Tetris2102/DIY_electron_detector/kicad_proj/documentation/3D_bottom_alpha.png

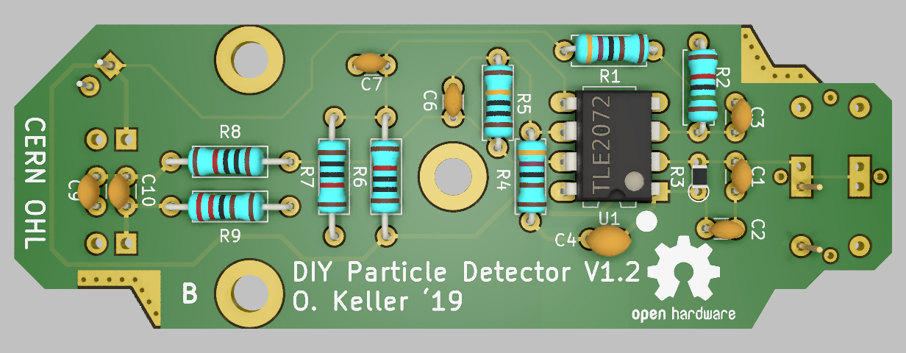
kicad_proj/documentation/3D_bottom_alpha.png
