Tetris2102/DIY_electron_detector/kicad_proj/documentation/3D_top_electron.png

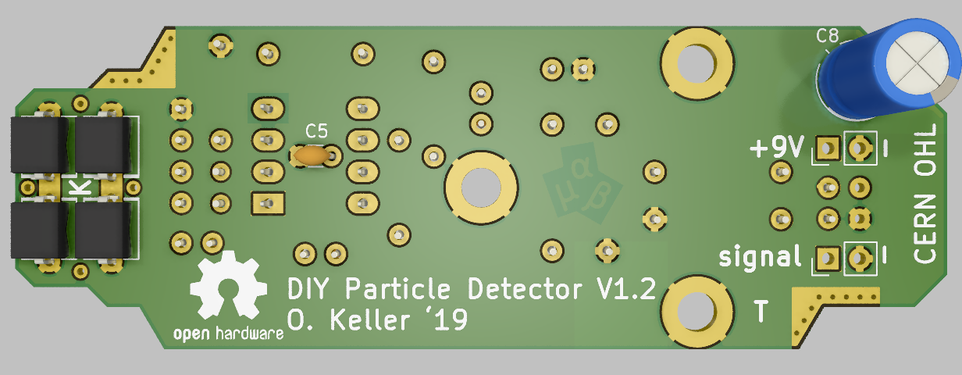
kicad_proj/documentation/3D_top_electron.png
