Tetris2102/DIY_electron_detector/kicad_proj/documentation/Alpha_spectrometer_in_candy_box_open.jpg

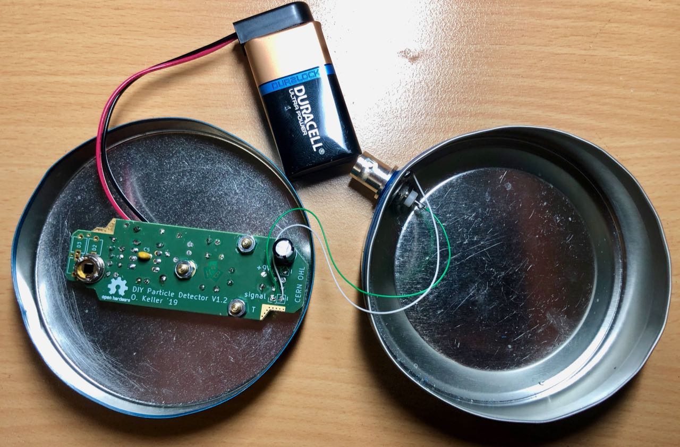
kicad_proj/documentation/Alpha_spectrometer_in_candy_box_open.jpg
