Tetris2102/DIY_electron_detector/kicad_proj/documentation/BPX61_onboard.jpg

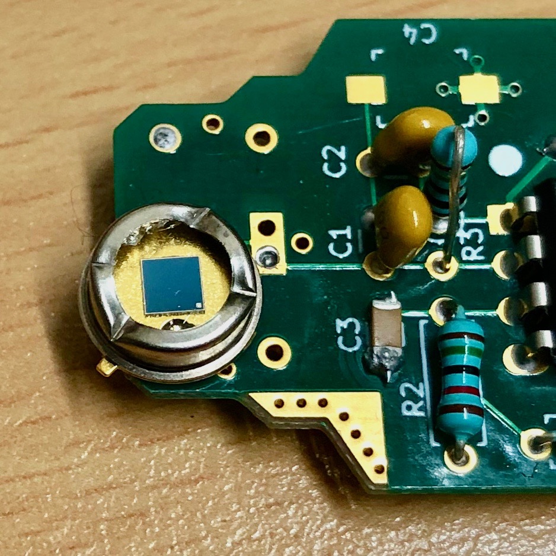
kicad_proj/documentation/BPX61_onboard.jpg
