Tetris2102/DIY_electron_detector/kicad_proj/documentation/BXP61_mircoscope.png

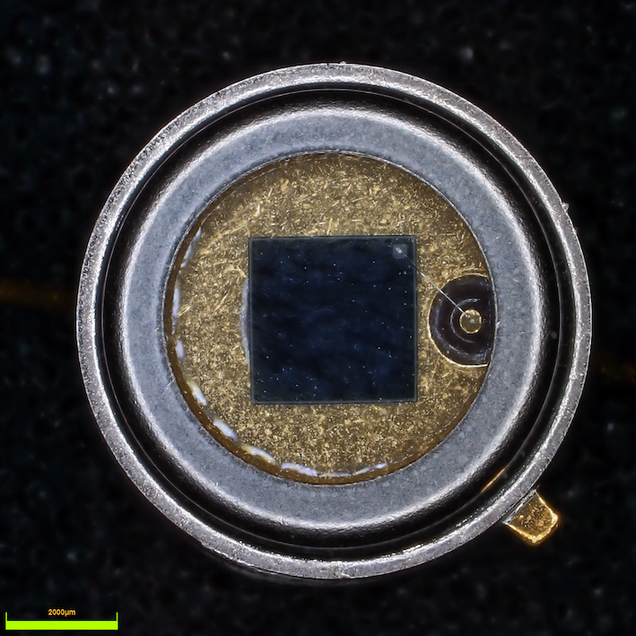
kicad_proj/documentation/BXP61_mircoscope.png
