Tetris2102/DIY_electron_detector/kicad_proj/documentation/DIY detector - parts overview v1-2 alphaspectrometer version.pdf

DIY Particle Detector v1.2 - overview of electronic components
1-diode variant for measuring energy of alpha particles and electrons
Resistor values in Ohm: | Capacitor values in Farad:
R1, R4 | 4k7 (4.7 k) | C1, C2 | 10 p
yellow purple black brown (brown) | marking: 100
R2 | 15 k | C3, C5, C7, C10 100 n
brown green black red (brown) | marking: 104
R3 | 40 M | C4 | C6 | C9
| 470 n | 3n3 | 6n8
black SMD resistor | (474) | (332) | (682)
(SMD = Surface Mounted Device)
C8 | 47 u
R5 | 1 M

polarity: short pin= - long pin = + brown black black yellow (brown) D1 or (http://www.apple.com/uk) D4: Silicon PIN Diode BPX61: R6, R7, R8 10 k
polarity: pin
| with notch
| = anode
brown black black red (brown)
R9 | 2k2 (2.2 k)

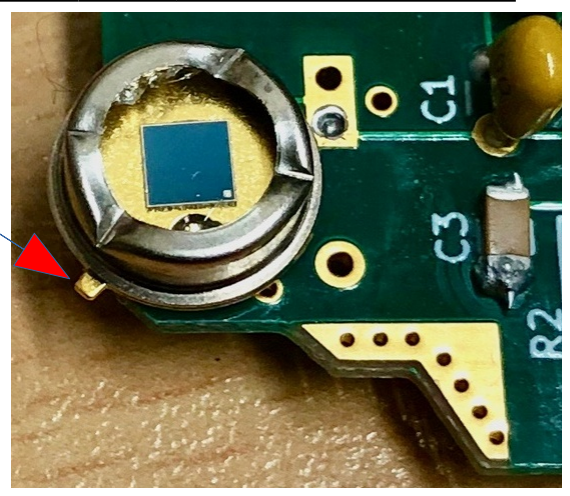
[picture p9: figure]

U1 Dual Operational Amplifier: red red black brown (brown)
| | | TLE2072(A)CP
| | | polarity: circles
| | | mark position of
| | | pin 1

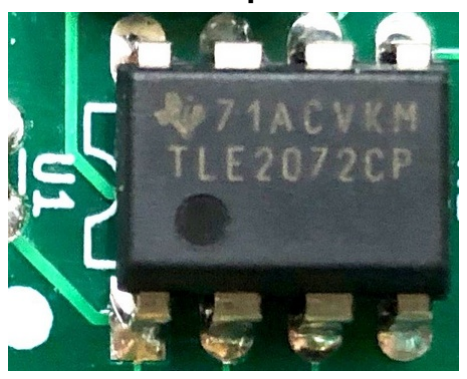
[picture p10: figure]

Check the main project description and schematic for general notes: www.github.com/ozel/DIY_particle_detector

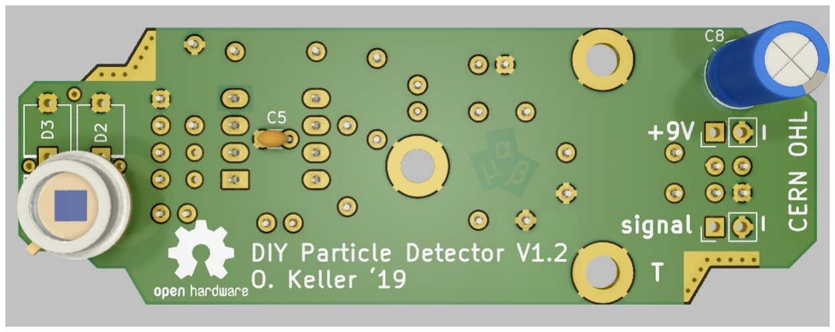
[picture p11: figure]
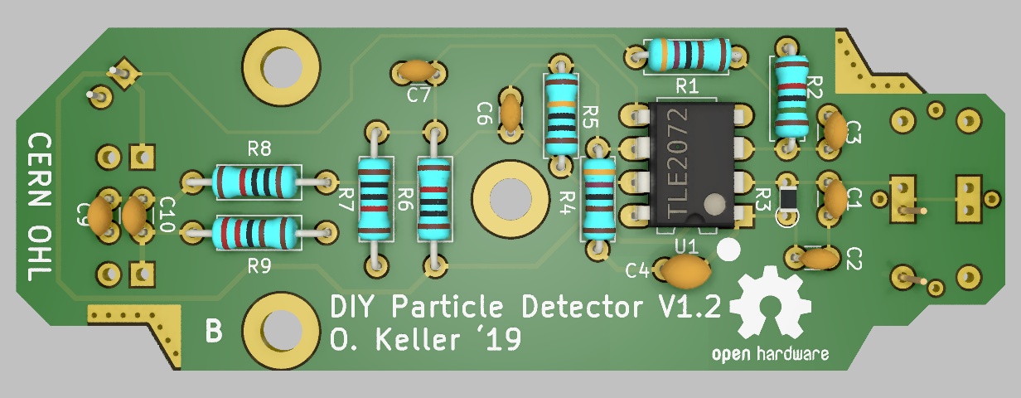
[picture p12: figure]
