Tetris2102/DIY_electron_detector/kicad_proj/3D/TLE2072.step

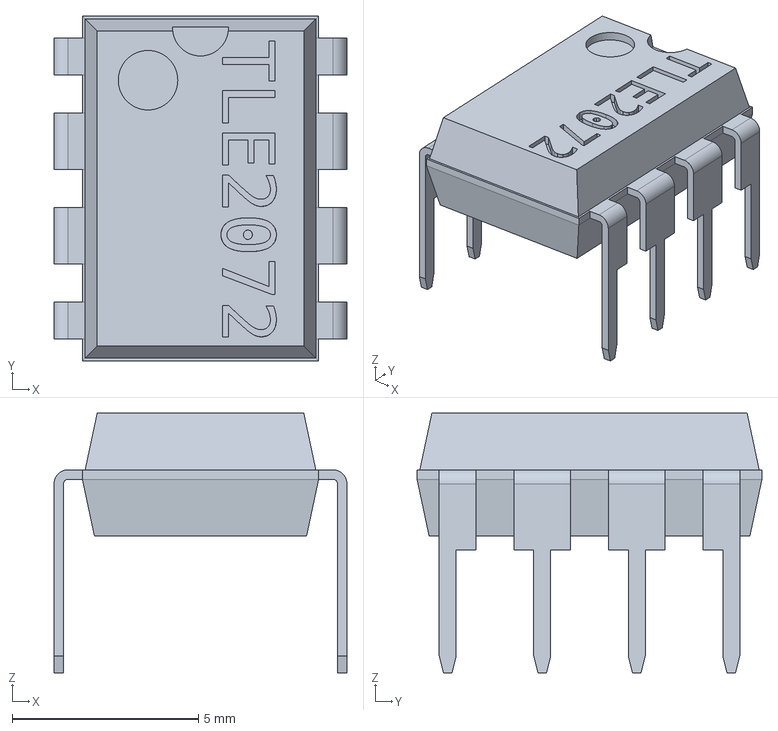
[picture p23: CAD file, 2025-08-24]
kicad_proj/3D/TLE2072.step
7.87 x 9.27 x 6.98 mm
