Tetris2102/DIY_electron_detector/kicad_proj/3D/BPX61.step

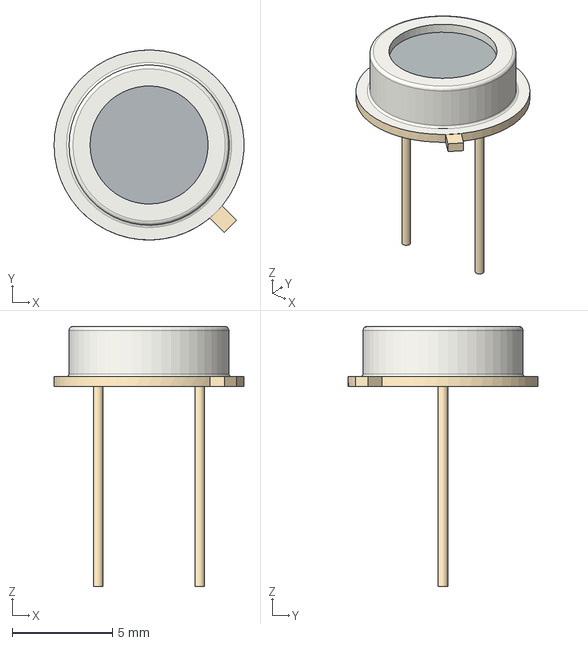
[picture p24: CAD file, 2025-08-24]
kicad_proj/3D/BPX61.step
9.49 x 9.50 x 13.0 mm
