Tetris2102/DIY_electron_detector/kicad_proj/3D/R_0805_2012Metric_THTorigin.FCStd

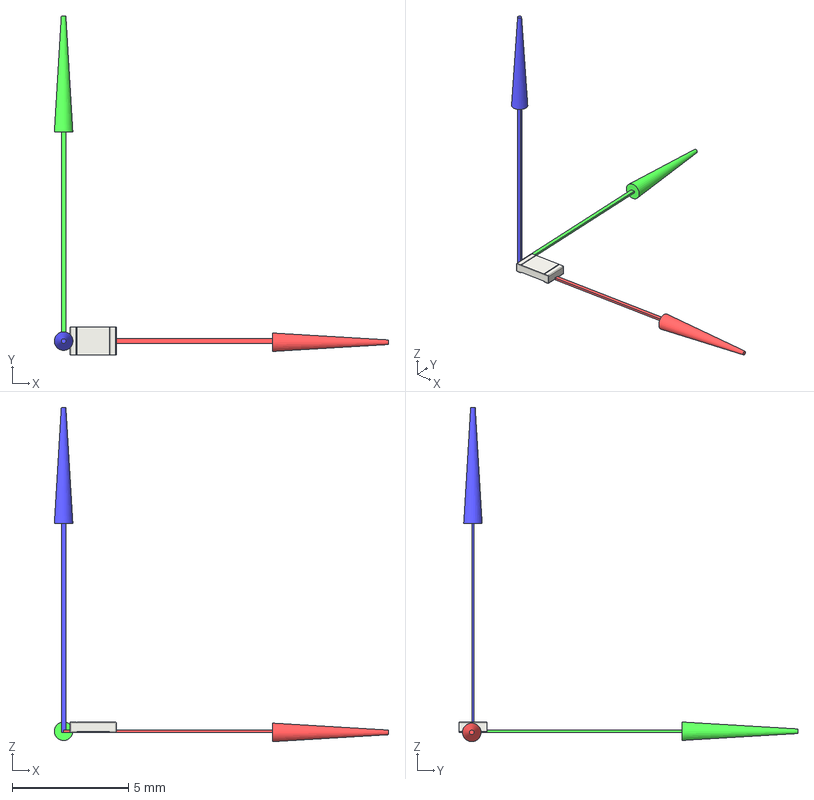
[picture p25: CAD file, 2025-08-24]
kicad_proj/3D/R_0805_2012Metric_THTorigin.FCStd
14.4 x 14.6 x 14.4 mm
R_0805_2012Metric_THTorigin
Z
Y
X
