Tetris2102/DIY_electron_detector/kicad_proj/3D/BPW34.FCStd

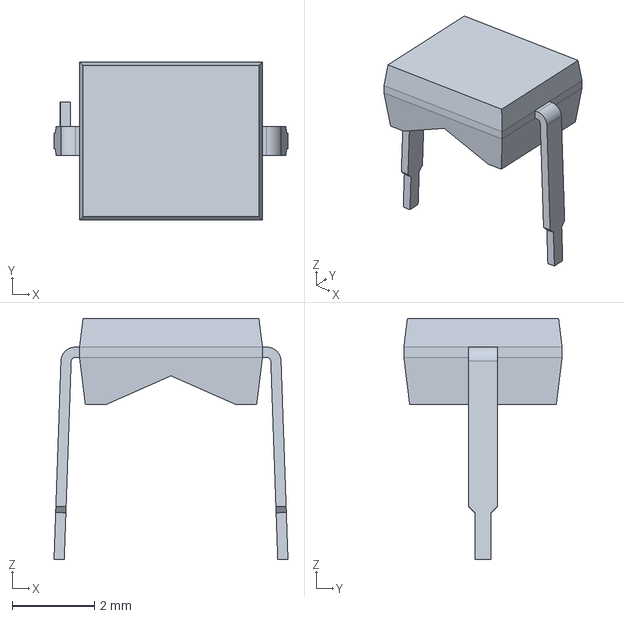
[picture p26: CAD file, 2025-08-24]
kicad_proj/3D/BPW34.FCStd
5.69 x 3.85 x 5.87 mm
