Tetris2102/DIY_electron_detector/(list of files, cad)

Other CAD files:
kicad_proj/3D/TLE2072ACP.FCStd
kicad_proj/3D/BPW34F.step
kicad_proj/3D/BPX61.FCStd
