Tetris2102/DIY_electron_detector/kicad_proj/documentation/DIY particle detector schematic v1-2.pdf

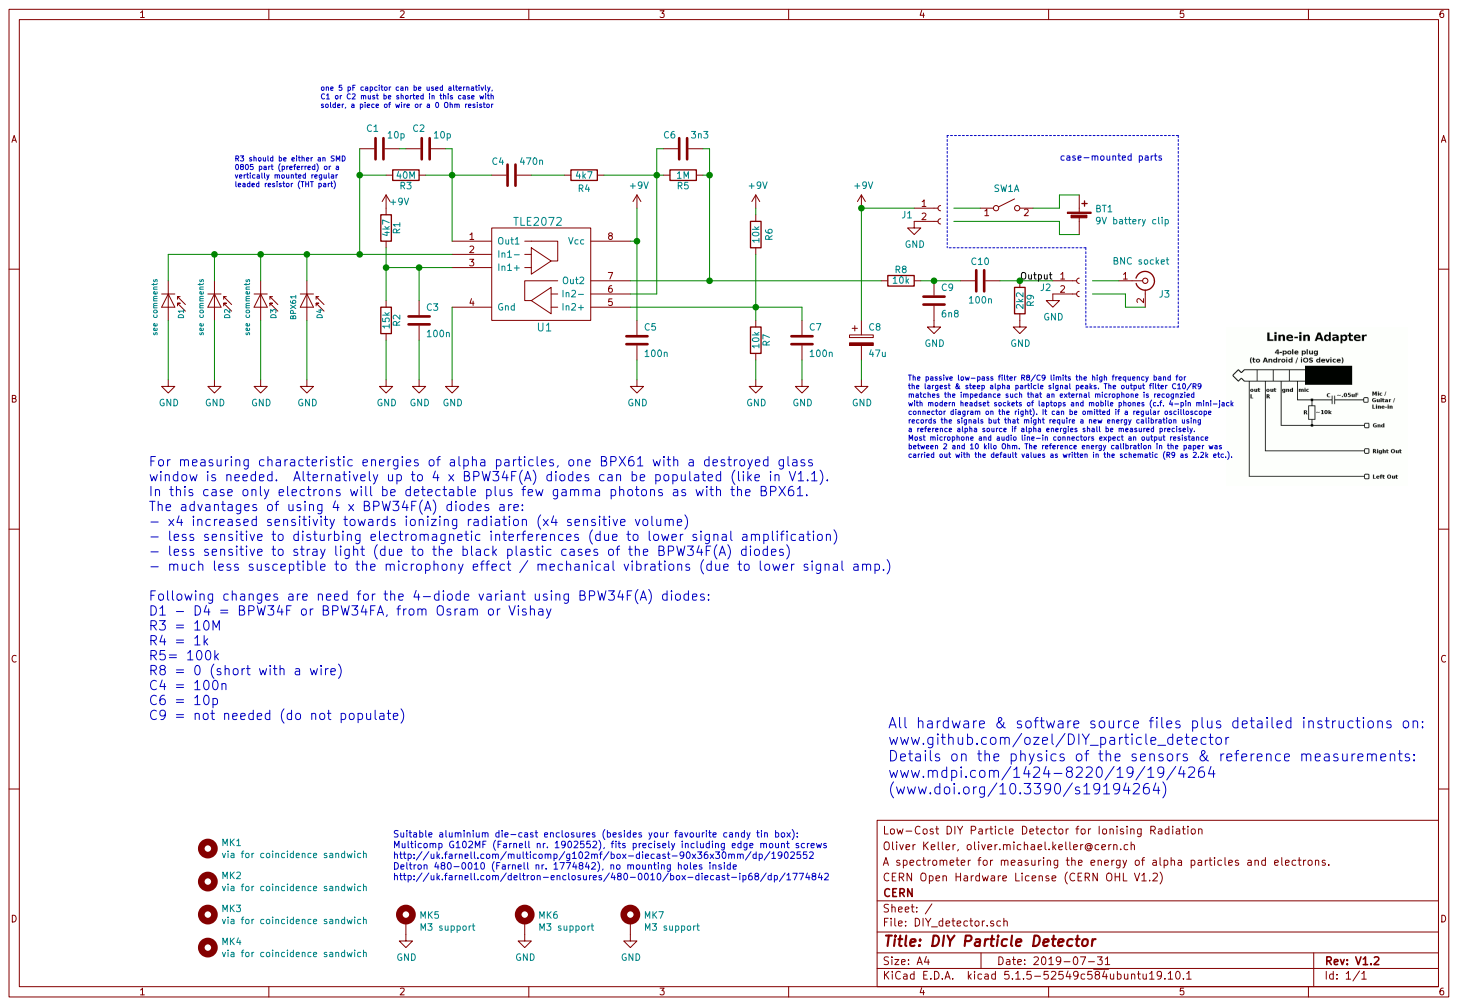
[picture p27: page 1]

one 5 pF capcitor can be used alternativly, C1 or C2 must be shorted in this case with solder, a piece of wire or a 0 Ohm resistor

0805 part (preferred) or a vertically mounted regular

The passive low-pass filter R8/C9 limits the high frequency band for
the largest & steep alpha particle signal peaks. The output filter C10/R9 matches the impedance such that an external microphone is recognzied with modern headset sockets of laptops and mobile phones (c.f. 4-pin mini-jack connector diagram on the right). It can be omitted if a regular oscilloscope records the signals but that might require a new energy calibration using a reference alpha source if alpha energies shall be measured precisely. Most microphone and audio line-in connectors expect an output resistance between 2 and 10 kilo Ohm. The reference energy calibration in the paper was carried out with the default values as written in the schematic (R9 as 2.2k etc.).

For measuring characteristic energies of alpha particles, one BPX61 with a destroyed glass
In this case only electrons will be detectable plus few gamma photons as with the BPX61.
The advantages of using 4 x BPW34F(A) diodes are:
- x4 increased sensitivity towards ionizing radiation (x4 sensitive volume)
- less sensitive to disturbing electromagnetic interferences (due to lower signal amplification)
- less sensitive to stray light (due to the black plastic cases of the BPW34F(A) diodes)
- much less susceptible to the microphony effect / mechanical vibrations (due to lower signal amp.)

Following changes are need for the 4-diode variant using BPW34F(A) diodes:
D1 - D4 = BPW34F or BPW34FA, from Osram or Vishay
R8 = 0 (short with a wire)
C9 = not needed (do not populate)

www.github.com/ozel/DIY_particle_detector
Details on the physics of the sensors & reference measurements:
www.mdpi.com/1424-8220/19/19/4264
(www.doi.org/10.3390/s19194264)

Low-Cost DIY Particle Detector for Ionising Radiation MK3

Suitable aluminium die-cast enclosures (besides your favourite candy tin box):
Multicomp G102MF (Farnell nr. 1902552), fits precisely including edge mount screws
http://uk.farnell.com/multicomp/g102mf/box-diecast-90x36x30mm/dp/1902552
Deltron 480-0010 (Farnell nr. 1774842), no mounting holes inside
http://uk.farnell.com/deltron-enclosures/480-0010/box-diecast-ip68/dp/1774842

Oliver Keller, oliver.michael.keller@cern.ch
A spectrometer for measuring the energy of alpha particles and electrons.
CERN Open Hardware License (CERN OHL V1.2)
File: DIY_detector.sch Sheet: / CERN

via for coincidence sandwich

Id: 1/1 Title: DIY Particle Detector
