Tetris2102/DIY_electron_detector/kicad_proj/DIY_detector.kicad_pcb

## KiCad design kicad_proj/DIY_detector.kicad_pcb (2025-08-24)

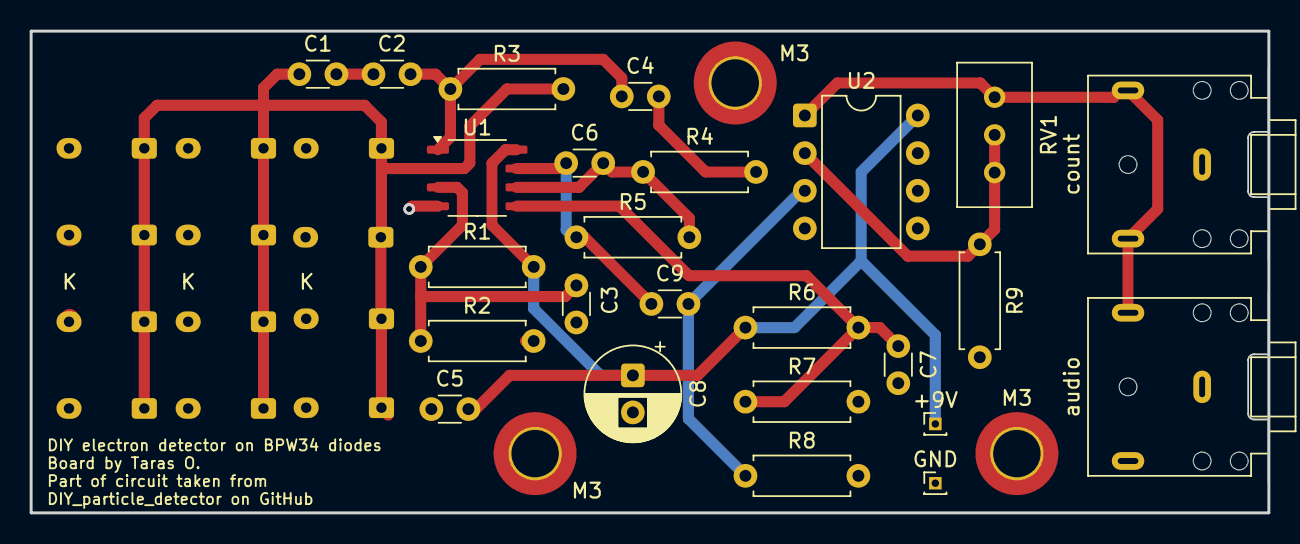
[picture p28: board DIY_detector.kicad_pcb from above]

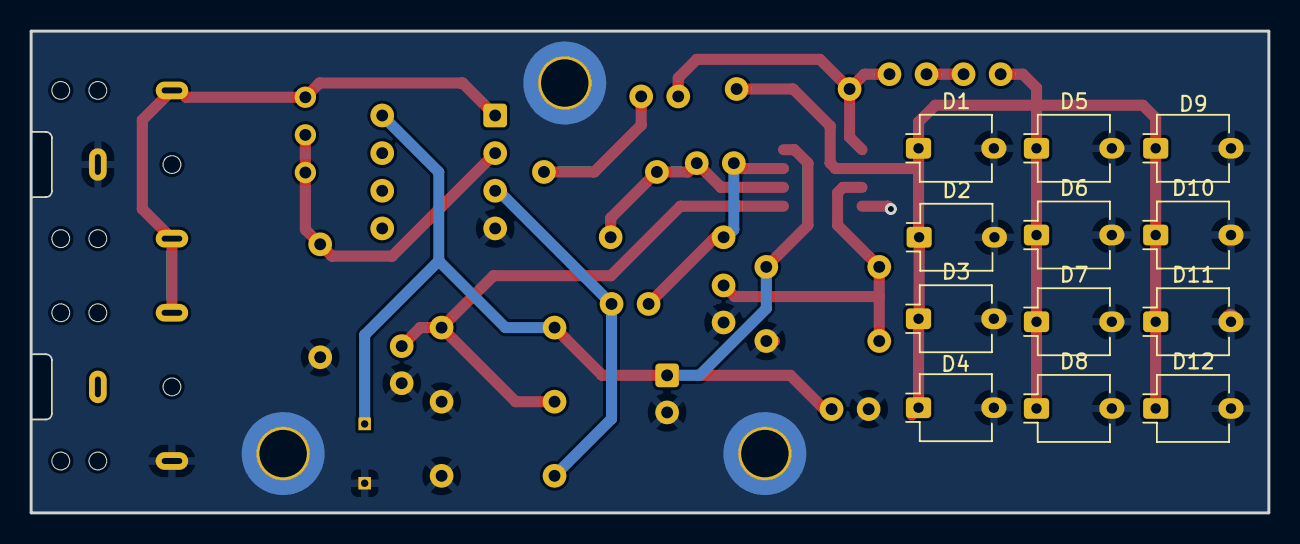
[picture p29: board DIY_detector.kicad_pcb from below]

Board: 2 copper layers, 83.5 x 32.5 mm, 40 parts (12 on the bottom side), 13 nets.

Parts:
+9V: +9V; PinHeader_1x01_P1.00mm_Vertical
C1, C2, C6: 10p; C_Disc_D3.0mm_W1.6mm_P2.50mm
C3, C4, C5, C7, C9: 100n; C_Disc_D3.0mm_W1.6mm_P2.50mm
C8: 47u; CP_Radial_D6.3mm_P2.50mm
D1, D8, D12: BPX61; Osram_DIL2_4.3x4.65mm_P5.08mm
D2, D3, D4, D5, D6, D7, D9, D10, D11: DNP; Osram_DIL2_4.3x4.65mm_P5.08mm
GND: GND; PinHeader_1x01_P1.00mm_Vertical
M3, M3#2, M3#3: M3 support; MountingHole_3.2mm_M3_DIN965_Pad_TopBottom
R1: 4k7; R_Axial_DIN0207_L6.3mm_D2.5mm_P7.62mm_Horizontal
R2: 15k; R_Axial_DIN0207_L6.3mm_D2.5mm_P7.62mm_Horizontal
R3: 10M; R_Axial_DIN0207_L6.3mm_D2.5mm_P7.62mm_Horizontal
R4: 1K; R_Axial_DIN0207_L6.3mm_D2.5mm_P7.62mm_Horizontal
R5: 100k; R_Axial_DIN0207_L6.3mm_D2.5mm_P7.62mm_Horizontal
R6, R7: 10k; R_Axial_DIN0207_L6.3mm_D2.5mm_P7.62mm_Horizontal
R8: 2k2; R_Axial_DIN0207_L6.3mm_D2.5mm_P7.62mm_Horizontal
R9: 3k3; R_Axial_DIN0207_L6.3mm_D2.5mm_P7.62mm_Horizontal
RV1: 100k; Potentiometer_Bourns_3296W_Vertical
U1: OPA2140; JEITA_SOIC-8_3.9x4.9mm_P1.27mm
U2: LM358; DIP-8_W7.62mm
audio: audio; Jack_3.5mm_CUI_SJ1-3523N_Horizontal
count: spectrum; Jack_3.5mm_CUI_SJ1-3523N_Horizontal

Connections:
+9V: +9V.1, C5.2, C8.1, R1.2, R6.1, U1.8 (Vcc), U2.8 (V+)
/Output: C9.2, R8.1, U2.3 (+)
GND: C3.2, C5.1, C7.2, C8.2, D1.2 (A), D2.2 (A), D3.2 (A), D4.2 (A), D5.2 (A), D6.2 (A), D7.2 (A), D8.2 (A), D9.2 (A), D10.2 (A), D11.2 (A), D12.2 (A), GND.1, M3.1, M3#2.1, M3#3.1, R2.2, R7.2, R8.2, R9.2, U1.4 (Gnd), U2.4 (V-), audio.R, count.S
unnamed: C1.2, C2.1
unnamed: C4.2, R4.2
unnamed: C1.1, D1.1 (K), D2.1 (K), D3.1 (K), D4.1 (K), D5.1 (K), D6.1 (K), D7.1 (K), D8.1 (K), D9.1 (K), D10.1 (K), D11.1 (K), D12.1 (K), R3.2, U1.2 (In1-)
unnamed: RV1.3, U2.1, audio.T, count.R, count.T
unnamed: C3.1, R1.1, R2.1, U1.3 (In1+)
unnamed: C7.1, R6.2, R7.1, U1.5 (In2+)
unnamed: C6.2, R4.1, R5.2, U1.6 (In2-)
unnamed: C2.2, C4.1, R3.1, U1.1 (Out1)
unnamed: C6.1, C9.1, R5.1, U1.7 (Out2)
unnamed: R9.1, RV1.1, RV1.2, U2.2 (-)
