Tetris2102/DIY_electron_detector/kicad_proj/DIY_detector_electron-variant.kicad_pcb

## KiCad design kicad_proj/DIY_detector_electron-variant.kicad_pcb (2025-08-24)

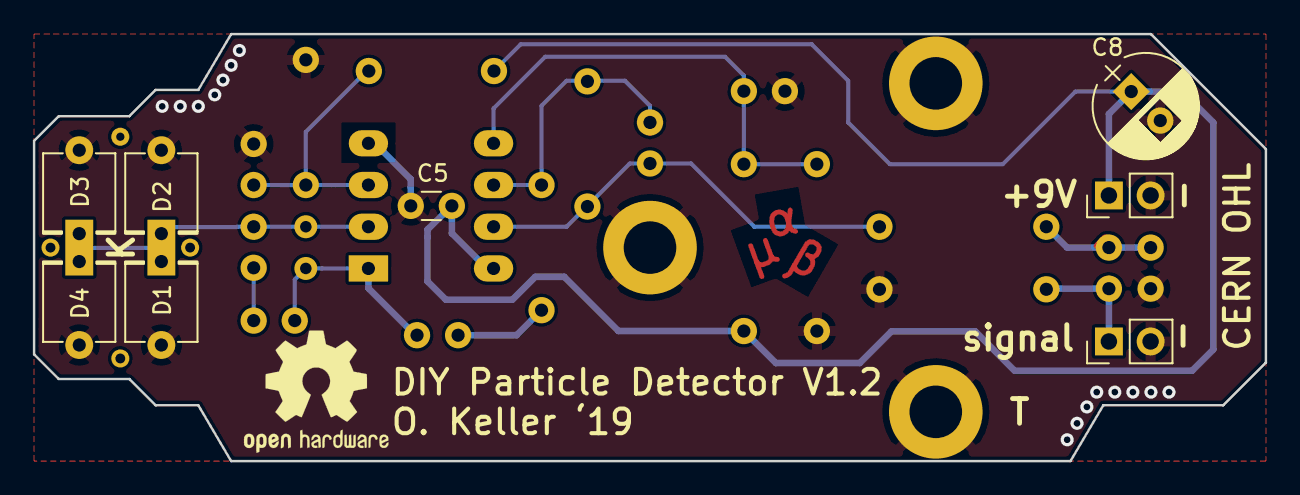
[picture p30: board DIY_detector_electron-variant.kicad_pcb from above]

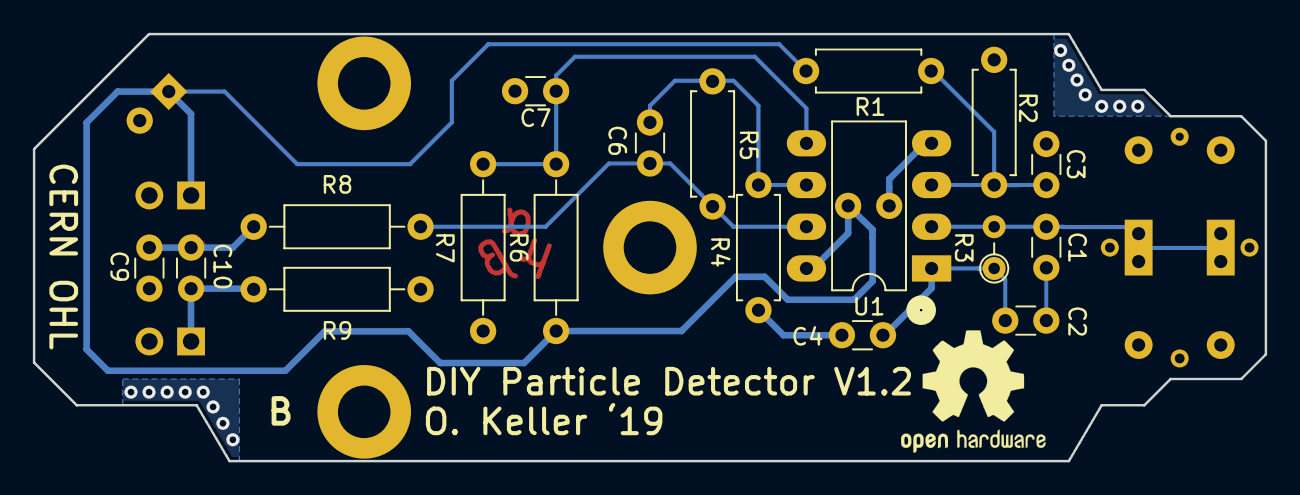
[picture p31: board DIY_detector_electron-variant.kicad_pcb from below]

Board: 2 copper layers, 75.0 x 26.0 mm, 33 parts (18 on the bottom side), 12 nets.

Parts:
C1, C2, C6: 10p; C_Disc_D3.0mm_W1.6mm_P2.50mm
C3, C4, C5, C7, C10: 100n; C_Disc_D3.0mm_W1.6mm_P2.50mm
C8: 47u; CP_Radial_D6.3mm_P2.50mm
C9: DNP; C_Disc_D3.0mm_W1.6mm_P2.50mm
D1, D2, D3, D4: BPW34F; PhotoDiode_DIL2_4.3x4.65_RM5.08
J1, J2: Conn_01x02_Female; Pin_Header_Straight_1x02_Pitch2.54mm
MK1, MK2, MK3, MK4: via for coincidence sandwich; SolderWirePad_single_0-8mmDrill
MK5, MK6, MK7: M3 support; MountingHole_3.2mm_M3_ISO7380_Pad
R1: 4k7; R_Axial_DIN0207_L6.3mm_D2.5mm_P7.62mm_Horizontal
R2: 15k; R_Axial_DIN0207_L6.3mm_D2.5mm_P7.62mm_Horizontal
R3: 10M; R_Axial_DIN0204_L3.6mm_D1.6mm_P2.54mm_Vertical
R4: 1k; R_Axial_DIN0207_L6.3mm_D2.5mm_P7.62mm_Horizontal
R5: 100k; R_Axial_DIN0207_L6.3mm_D2.5mm_P7.62mm_Horizontal
R6, R7: 10k; R_Axial_DIN0207_L6.3mm_D2.5mm_P10.16mm_Horizontal
R8: 0; R_Axial_DIN0207_L6.3mm_D2.5mm_P10.16mm_Horizontal
R9: 2k2; R_Axial_DIN0207_L6.3mm_D2.5mm_P10.16mm_Horizontal
U1: TLE2072; DIP-8_W7.62mm_LongPads

Connections:
+9V: C5.1, C8.1, J1.1, R1.1, R6.1, U1.8
/Output: C10.2, J2.1, R9.1
GND: C3.2, C5.2, C7.2, C8.2, C9.2, D1.2, D2.2, D3.2, D4.2, J1.2, J2.2, MK5.1, MK6.1, MK7.1, R2.2, R7.2, R9.2, U1.4
unnamed: C1.1, D1.1, D2.1, D3.1, D4.1, R3.2, U1.2
unnamed: C1.2, C2.1
unnamed: C2.2, C4.1, R3.1, U1.1
unnamed: C3.1, R1.2, R2.1, U1.3
unnamed: C4.2, R4.2
unnamed: C6.1, R4.1, R5.2, U1.6
unnamed: C6.2, R5.1, R8.1, U1.7
unnamed: C7.1, R6.2, R7.1, U1.5
unnamed: C9.1, C10.1, R8.2
