Tetris2102/DIY_electron_detector/(notices)

Notices in the files:
kicad_proj/DIY_detector_electron-variant.kicad_pcb:
CERN open hardware license V1.2
